reefstarnes/Solar_Glide_VTOL/Flightcontrol/README.md

# Flight control
Flight Controller:

Flasher4OTG:
