reefstarnes/Solar_Glide_VTOL/Flightcontrol/flashing_tool/dependencies/1N5819HW_7_F/1N5819HW-7-F.step

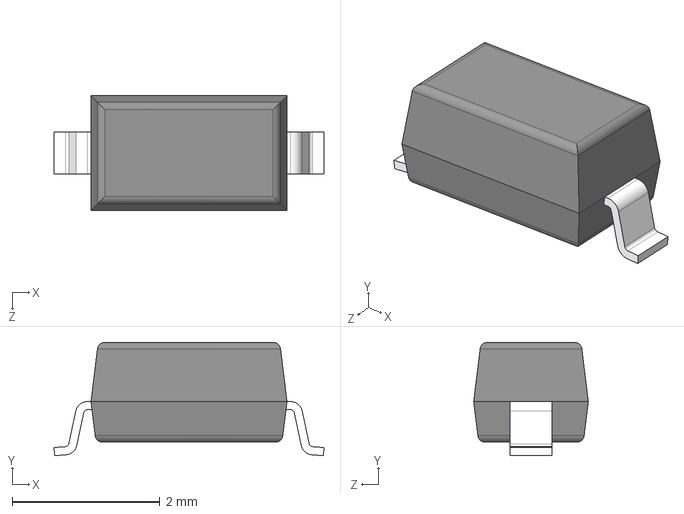
[picture p34: CAD file, 2025-10-27]
Flightcontrol/flashing_tool/dependencies/1N5819HW_7_F/1N5819HW-7-F.step
3.65 x 1.53 x 1.55 mm
