reefstarnes/Solar_Glide_VTOL/Flightcontrol/flashing_tool/dependencies/AMS1117-3.3/AMS1117-3.3.step

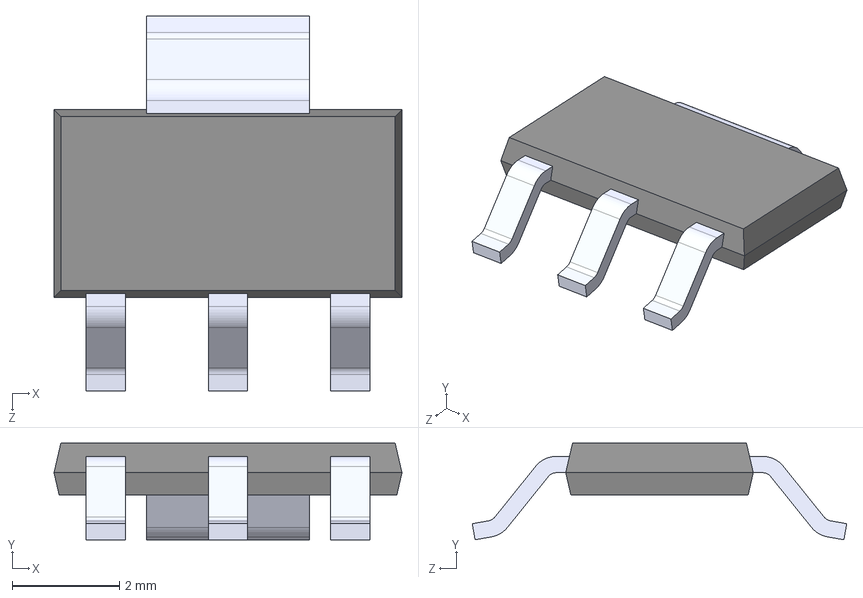
[picture p35: CAD file, 2025-11-11]
Flightcontrol/flashing_tool/dependencies/AMS1117-3.3/AMS1117-3.3.step
6.50 x 1.80 x 7.00 mm
