reefstarnes/Solar_Glide_VTOL/Flightcontrol/flashing_tool/dependencies/ESP32_S3_WROOM_1U_N16R8/ESP32-S3-WROOM-1U-N16R8.step

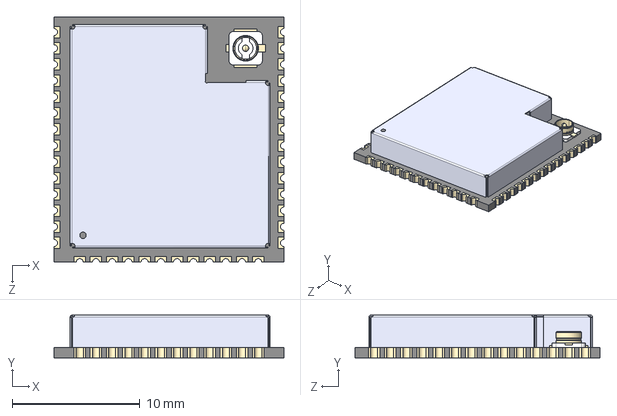
[picture p36: CAD file, 2025-10-26]
Flightcontrol/flashing_tool/dependencies/ESP32_S3_WROOM_1U_N16R8/ESP32-S3-WROOM-1U-N16R8.step
18.0 x 3.35 x 19.2 mm
