reefstarnes/Solar_Glide_VTOL/Flightcontrol/flashing_tool/dependencies/GSPTS0020/GSPTS0020.stp

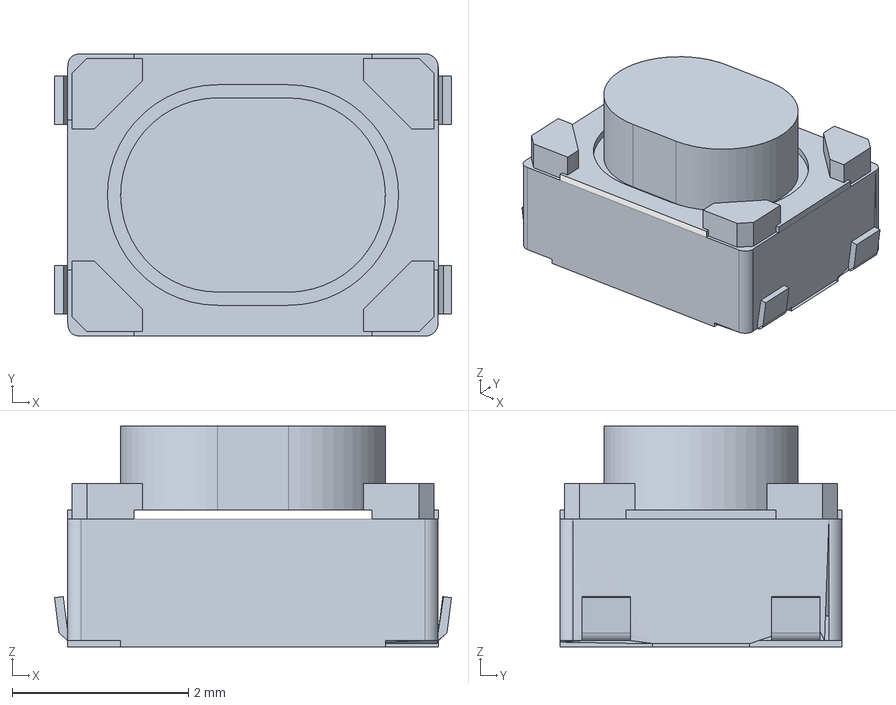
[picture p37: CAD file, 2025-11-11]
Flightcontrol/flashing_tool/dependencies/GSPTS0020/GSPTS0020.stp
4.50 x 3.20 x 2.50 mm
PTS815SJM250SMTRLFS_PART1
PTS815SJM250SMTRLFS_PART2
PTS815SJM250SMTRLFS_PART3
