reefstarnes/Solar_Glide_VTOL/Flightcontrol/flashing_tool/dependencies/TAJA226K010RNJ/TAJA226K010RNJ.step

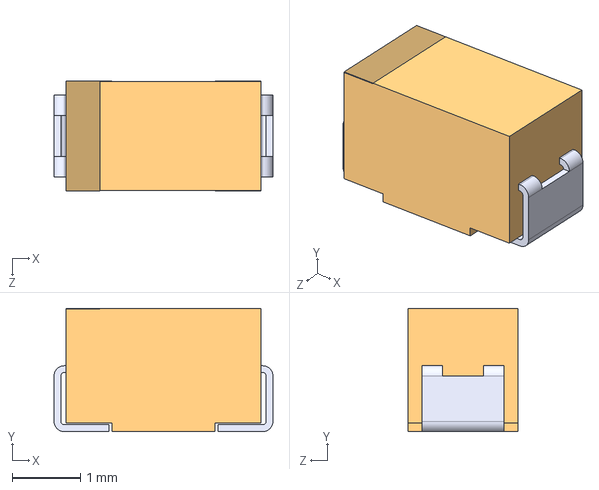
[picture p38: CAD file, 2025-11-11]
Flightcontrol/flashing_tool/dependencies/TAJA226K010RNJ/TAJA226K010RNJ.step
3.20 x 1.80 x 1.60 mm
