reefstarnes/Solar_Glide_VTOL/Flightcontrol/flashing_tool/dependencies/USBLC6_2SC6/USBLC6-2SC6.step

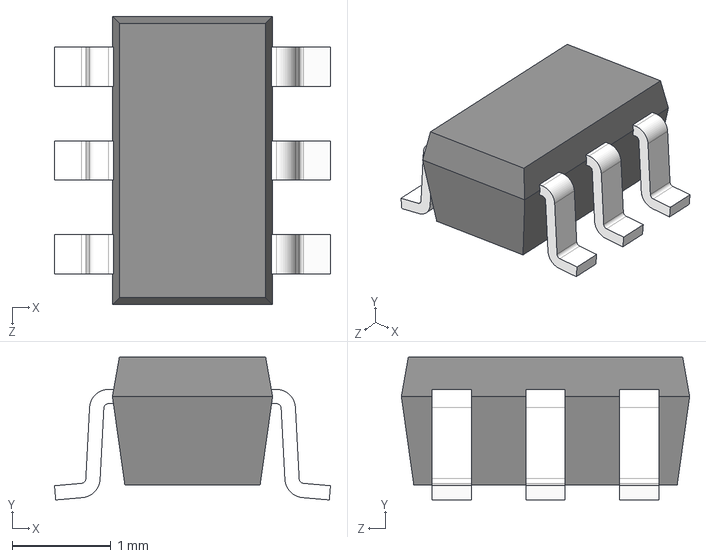
[picture p39: CAD file, 2025-10-27]
Flightcontrol/flashing_tool/dependencies/USBLC6_2SC6/USBLC6-2SC6.step
2.80 x 1.45 x 2.92 mm
