reefstarnes/Solar_Glide_VTOL/Flightcontrol/kicad/dependencies/BMP581/BMP581.stp

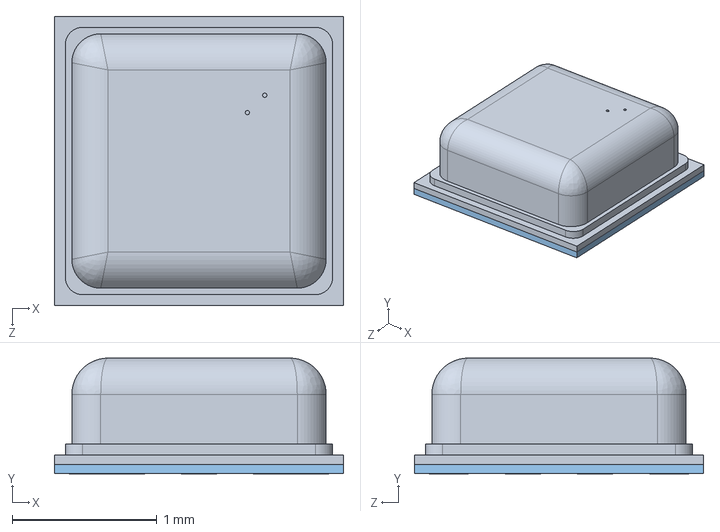
[picture p40: CAD file, 2025-11-11]
Flightcontrol/kicad/dependencies/BMP581/BMP581.stp
2.00 x 0.801 x 2.00 mm
