reefstarnes/Solar_Glide_VTOL/Flightcontrol/kicad/dependencies/CONN_CCSH-W10R-04TR-BK-A_ADA/SM04B-SRSS-TB.STEP

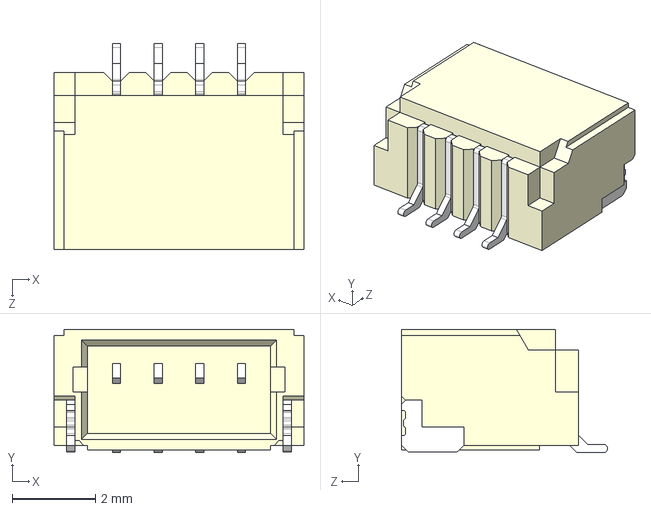
[picture p41: CAD file, 2025-11-11]
Flightcontrol/kicad/dependencies/CONN_CCSH-W10R-04TR-BK-A_ADA/SM04B-SRSS-TB.STEP
6.00 x 2.96 x 4.95 mm
