reefstarnes/Solar_Glide_VTOL/Flightcontrol/kicad/dependencies/CONN_SM03B-GHS-TBLFSN_JST/CONN_SM03B-GHS-TBLFSN_JST.STEP

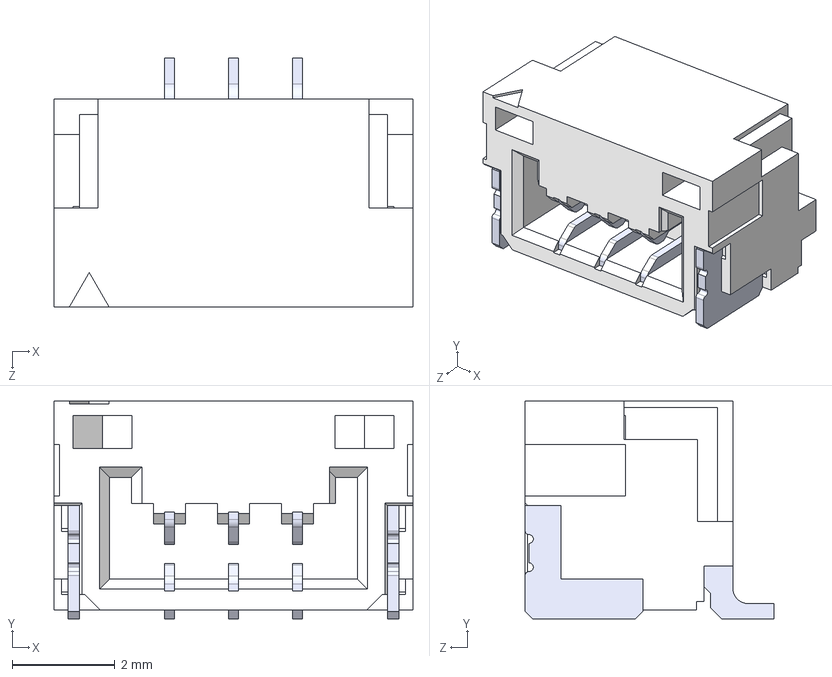
[picture p42: CAD file, 2025-11-11]
Flightcontrol/kicad/dependencies/CONN_SM03B-GHS-TBLFSN_JST/CONN_SM03B-GHS-TBLFSN_JST.STEP
7.00 x 4.25 x 4.85 mm
SMxB-GHS-TB_03
pin x 3
