reefstarnes/Solar_Glide_VTOL/Flightcontrol/kicad/dependencies/CONN_SM06B-GHS-TB_JST/CONN_SM06B-GHS-TB_JST.STEP

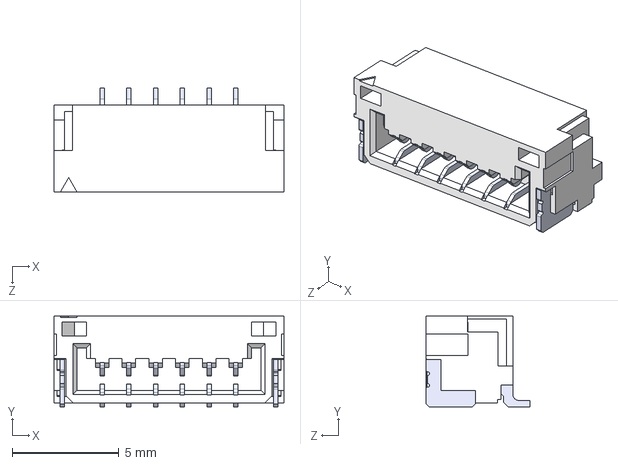
[picture p43: CAD file, 2025-11-11]
Flightcontrol/kicad/dependencies/CONN_SM06B-GHS-TB_JST/CONN_SM06B-GHS-TB_JST.STEP
10.8 x 4.25 x 4.85 mm
SMxB-GHS-TB_06
pin x 6
