reefstarnes/Solar_Glide_VTOL/Flightcontrol/kicad/dependencies/LESD5D5.0CT1G/LESD5D5.0CT1G.step

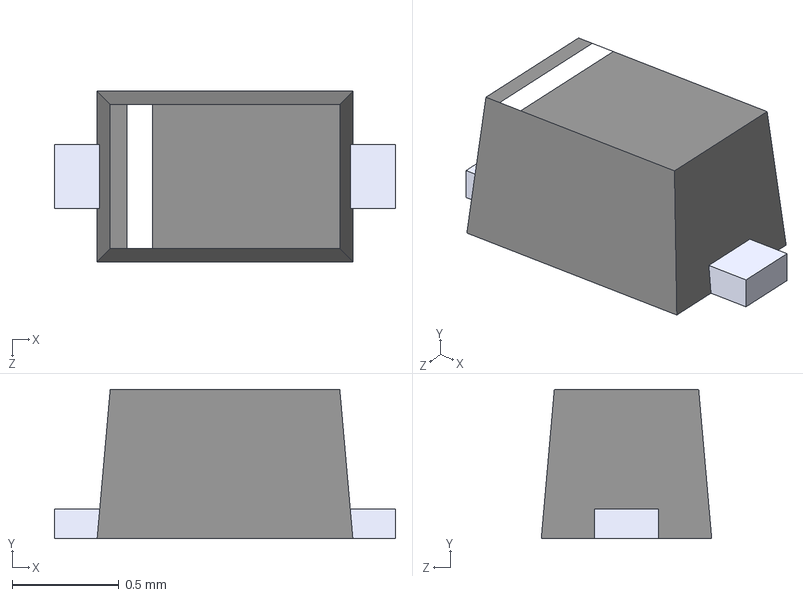
[picture p44: CAD file, 2025-10-30]
Flightcontrol/kicad/dependencies/LESD5D5.0CT1G/LESD5D5.0CT1G.step
1.60 x 0.7 x 0.8 mm
