reefstarnes/Solar_Glide_VTOL/Propcontrol/PropControl/Dependencies/C0603C103K5RACTU/C0603C103K5RACTU.step

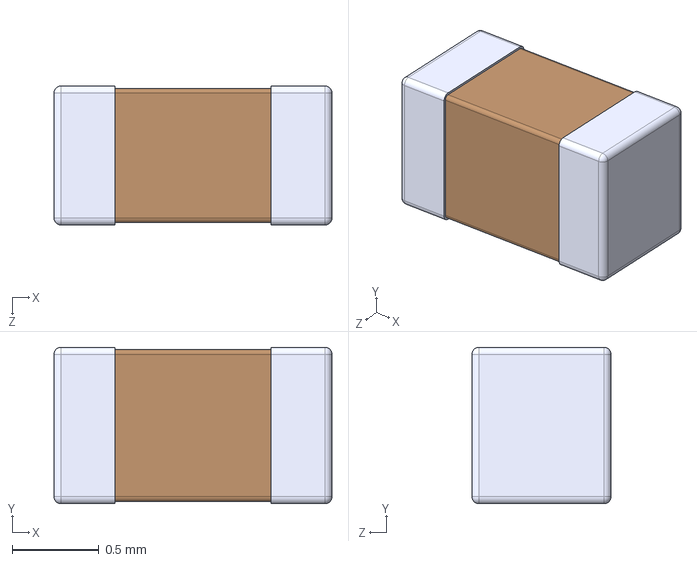
[picture p45: CAD file, 2025-11-11]
Propcontrol/PropControl/Dependencies/C0603C103K5RACTU/C0603C103K5RACTU.step
1.60 x 0.9 x 0.8 mm
