reefstarnes/Solar_Glide_VTOL/Propcontrol/PropControl/Dependencies/C0603C104K5RACTU/C0603C104K5RACTU.step

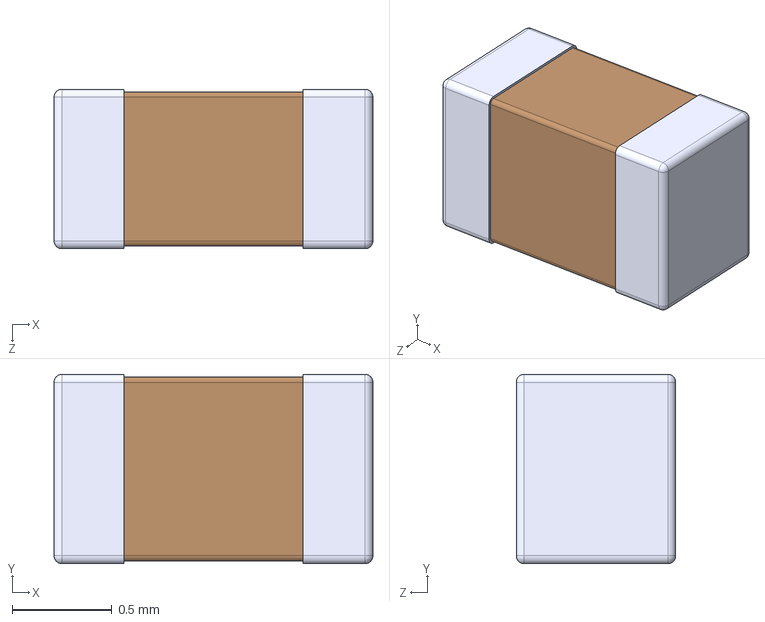
[picture p46: CAD file, 2025-11-11]
Propcontrol/PropControl/Dependencies/C0603C104K5RACTU/C0603C104K5RACTU.step
1.60 x 0.95 x 0.8 mm
