reefstarnes/Solar_Glide_VTOL/Propcontrol/PropControl/Dependencies/C3216X5R1E476M160AC/C3216X5R1E476M160AC.step

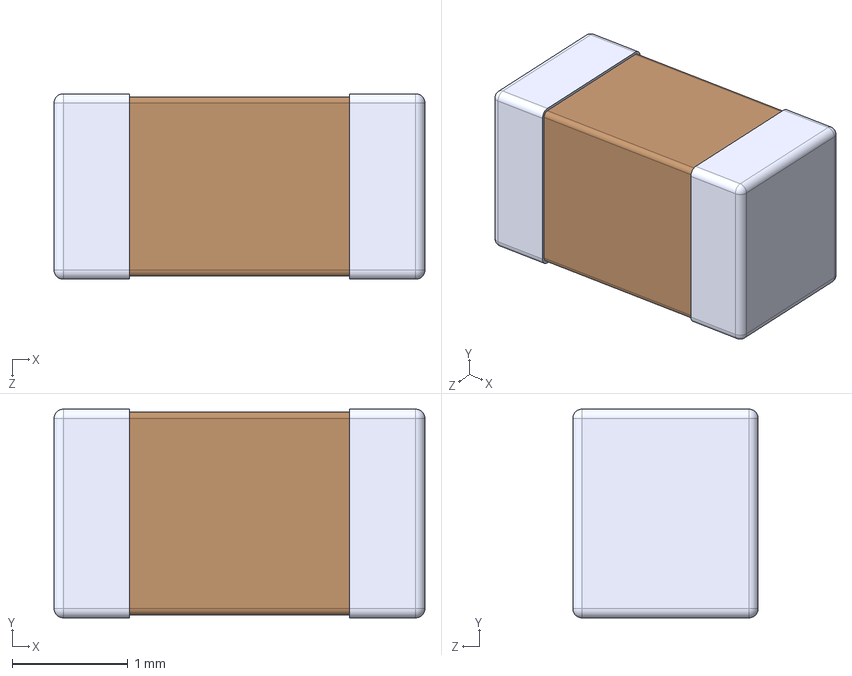
[picture p47: CAD file, 2025-11-11]
Propcontrol/PropControl/Dependencies/C3216X5R1E476M160AC/C3216X5R1E476M160AC.step
3.20 x 1.80 x 1.60 mm
