reefstarnes/Solar_Glide_VTOL/Propcontrol/PropControl/Dependencies/CL10B105KP8NNNC/CL10B105KP8NNNC.step

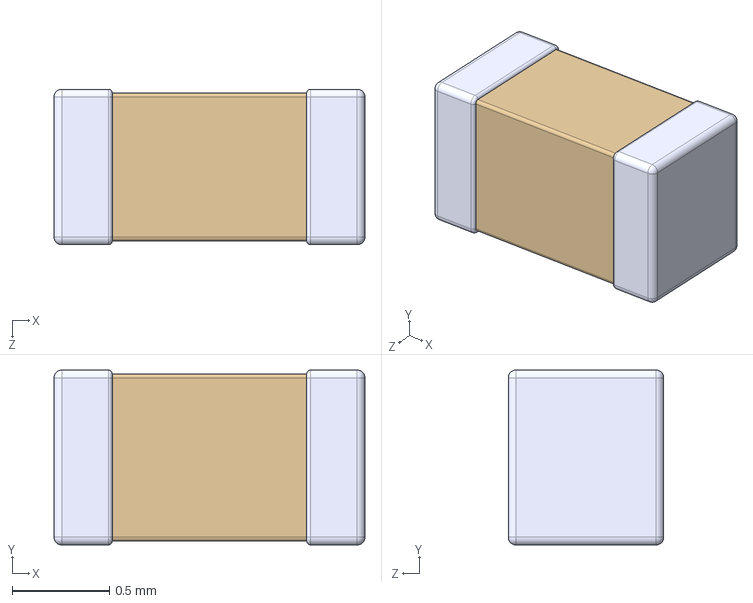
[picture p48: CAD file, 2026-01-29]
Propcontrol/PropControl/Dependencies/CL10B105KP8NNNC/CL10B105KP8NNNC.step
1.60 x 0.9 x 0.8 mm
