reefstarnes/Solar_Glide_VTOL/Propcontrol/PropControl/Dependencies/GRM188R61E106KA73D/GRM188R61E106KA73D.step

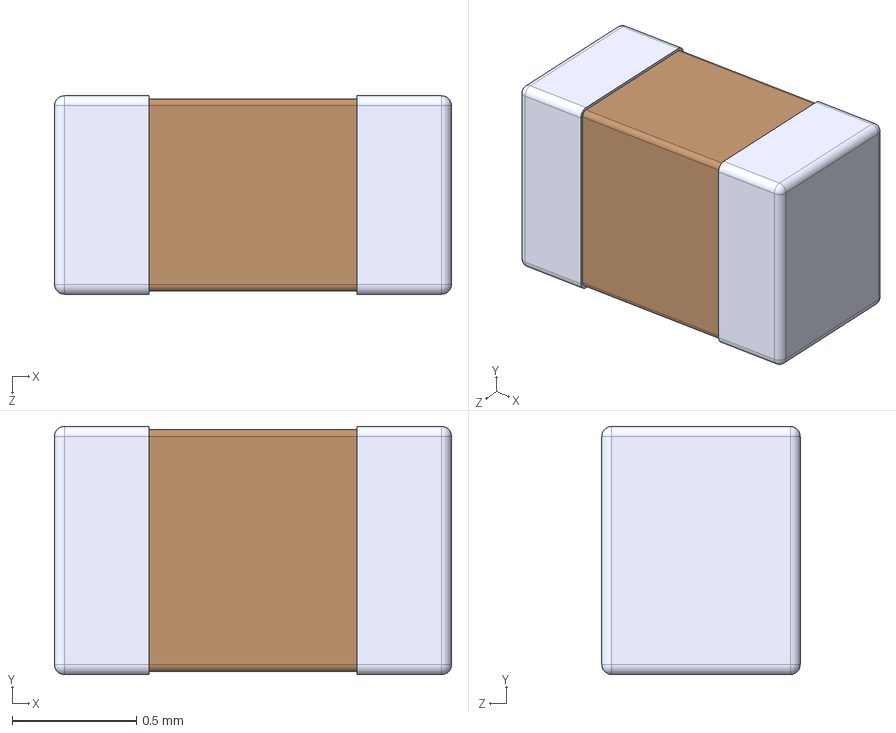
[picture p49: CAD file, 2025-11-11]
Propcontrol/PropControl/Dependencies/GRM188R61E106KA73D/GRM188R61E106KA73D.step
1.60 x 1.00 x 0.8 mm
