reefstarnes/Solar_Glide_VTOL/Propcontrol/PropControl/Dependencies/LM339D/LM339D.step

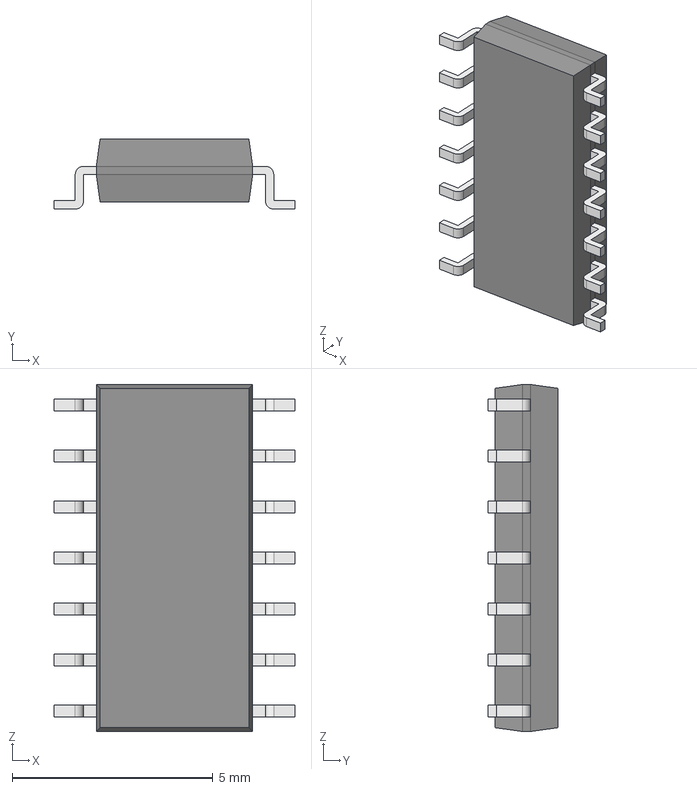
[picture p50: CAD file, 2025-11-11]
Propcontrol/PropControl/Dependencies/LM339D/LM339D.step
6.00 x 1.75 x 8.65 mm
Body001 (Mirror #1) x 7
XY-plane x 12
X-axis x 12
