reefstarnes/Solar_Glide_VTOL/Propcontrol/PropControl/Dependencies/STM32F030F4P6/STM32F030F4P6.step

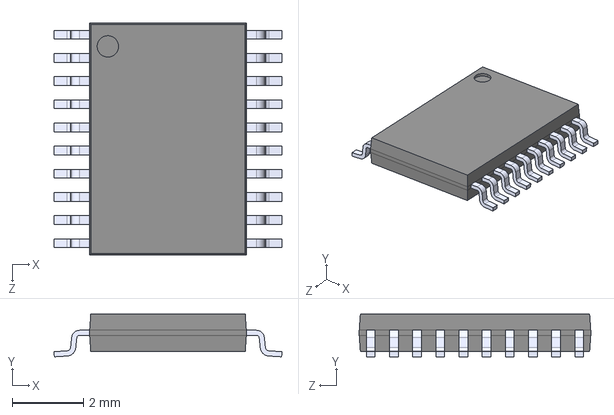
[picture p51: CAD file, 2025-11-11]
Propcontrol/PropControl/Dependencies/STM32F030F4P6/STM32F030F4P6.step
6.40 x 1.20 x 6.50 mm
