reefstarnes/Solar_Glide_VTOL/(list of files, cad)

Other CAD files:
Propcontrol/PropControl/Dependencies/UMK107AB7105KA_T (1)/UMK107AB7105KA-T.step
Flightcontrol/flashing_tool/dependencies/2171790001/2171790001.step
Propcontrol/PropControl/Dependencies/CSD18533Q5A/CSD18533Q5A.step
Propcontrol/PropControl/Dependencies/TPS62933DRLR/TPS62933DRLR.step
