reefstarnes/Solar_Glide_VTOL/(list of files, drawings)

Other design files:
Flightcontrol/testcode/COMM_SIMULATION_CIRCUIT.fzz
