reefstarnes/Solar_Glide_VTOL/Flightcontrol/flashing_tool/kicad.kicad_pcb

## KiCad design Flightcontrol/flashing_tool/kicad.kicad_pcb (2025-11-11)

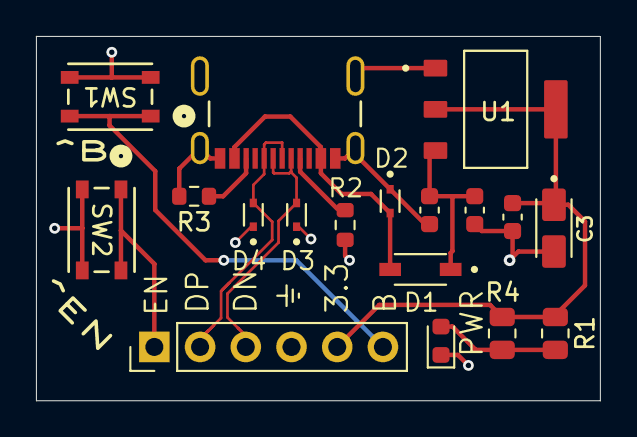
[picture p52: board Flightcontrol/flashing_tool/kicad.kicad_pcb from above]

Board: 2 copper layers, 31.3 x 20.2 mm, 18 parts (0 on the bottom side), 11 nets.

Parts:
C1, C4: 0.1uF; C_0603_1608Metric
C2: 10uF; C_0603_1608Metric
C3: 22uF; CAPMP3216X180N
D1: 1N5819HW-7-F; SOD3715X145N
D2, D3, D4: LESD5D5.0CT1G; TVS_LESD5D5.0CT1G
J1: 2171790001; MOLEX_2171790001
J2: Conn_01x06_Pin; PinHeader_1x06_P2.54mm_Vertical
PWR: LED; LED_0603_1608Metric
R1, R4: 560; R_0805_2012Metric
R2, R3: 5.1k; R_0603_1608Metric
SW1, SW2: PTS815 SJM 250 SMTR LFS; GSPTS0020
U1: AMS1117-3.3; SOT229P700X180-4N

Connections:
/3.3: C3.1, C4.1, J2.5, R1.1, R4.1, U1.2 (VOUT)
/D+: D4.2, J1.A6 (DP1), J1.B6 (DP2), J2.2
/D-: D3.2, J1.A7 (DN1), J1.B7 (DN2), J2.3
/S1: J2.1, SW2.1, SW2.2
/S2: J2.6, SW1.1, SW1.2
/VCC_5V: C1.1, C2.1, D1.C, U1.3 (VIN)
GND: C1.2, C2.2, C3.2, C4.2, D2.1, D3.1, D4.1, J1.A1B12 (GND1), J1.B1A12 (GND2), J1.SH1 (SHIELD1), J1.SH2 (SHIELD2), J1.SH3 (SHIELD3), J1.SH4 (SHIELD4), J2.4, PWR.1 (K), R2.2, R3.2, SW1.3, SW1.4, SW2.3, SW2.4, U1.1 (GND/ADJ)
unnamed: PWR.2 (A), R1.2, R4.2
unnamed: J1.A5 (CC1), R2.1
unnamed: J1.B5 (CC2), R3.1
unnamed: D1.A, D2.2, J1.A4B9 (VBUS1), J1.B4A9 (VBUS2)
