reefstarnes/Solar_Glide_VTOL/Flightcontrol/kicad/kicad.kicad_pcb

## KiCad design Flightcontrol/kicad/kicad.kicad_pcb (2025-11-11)

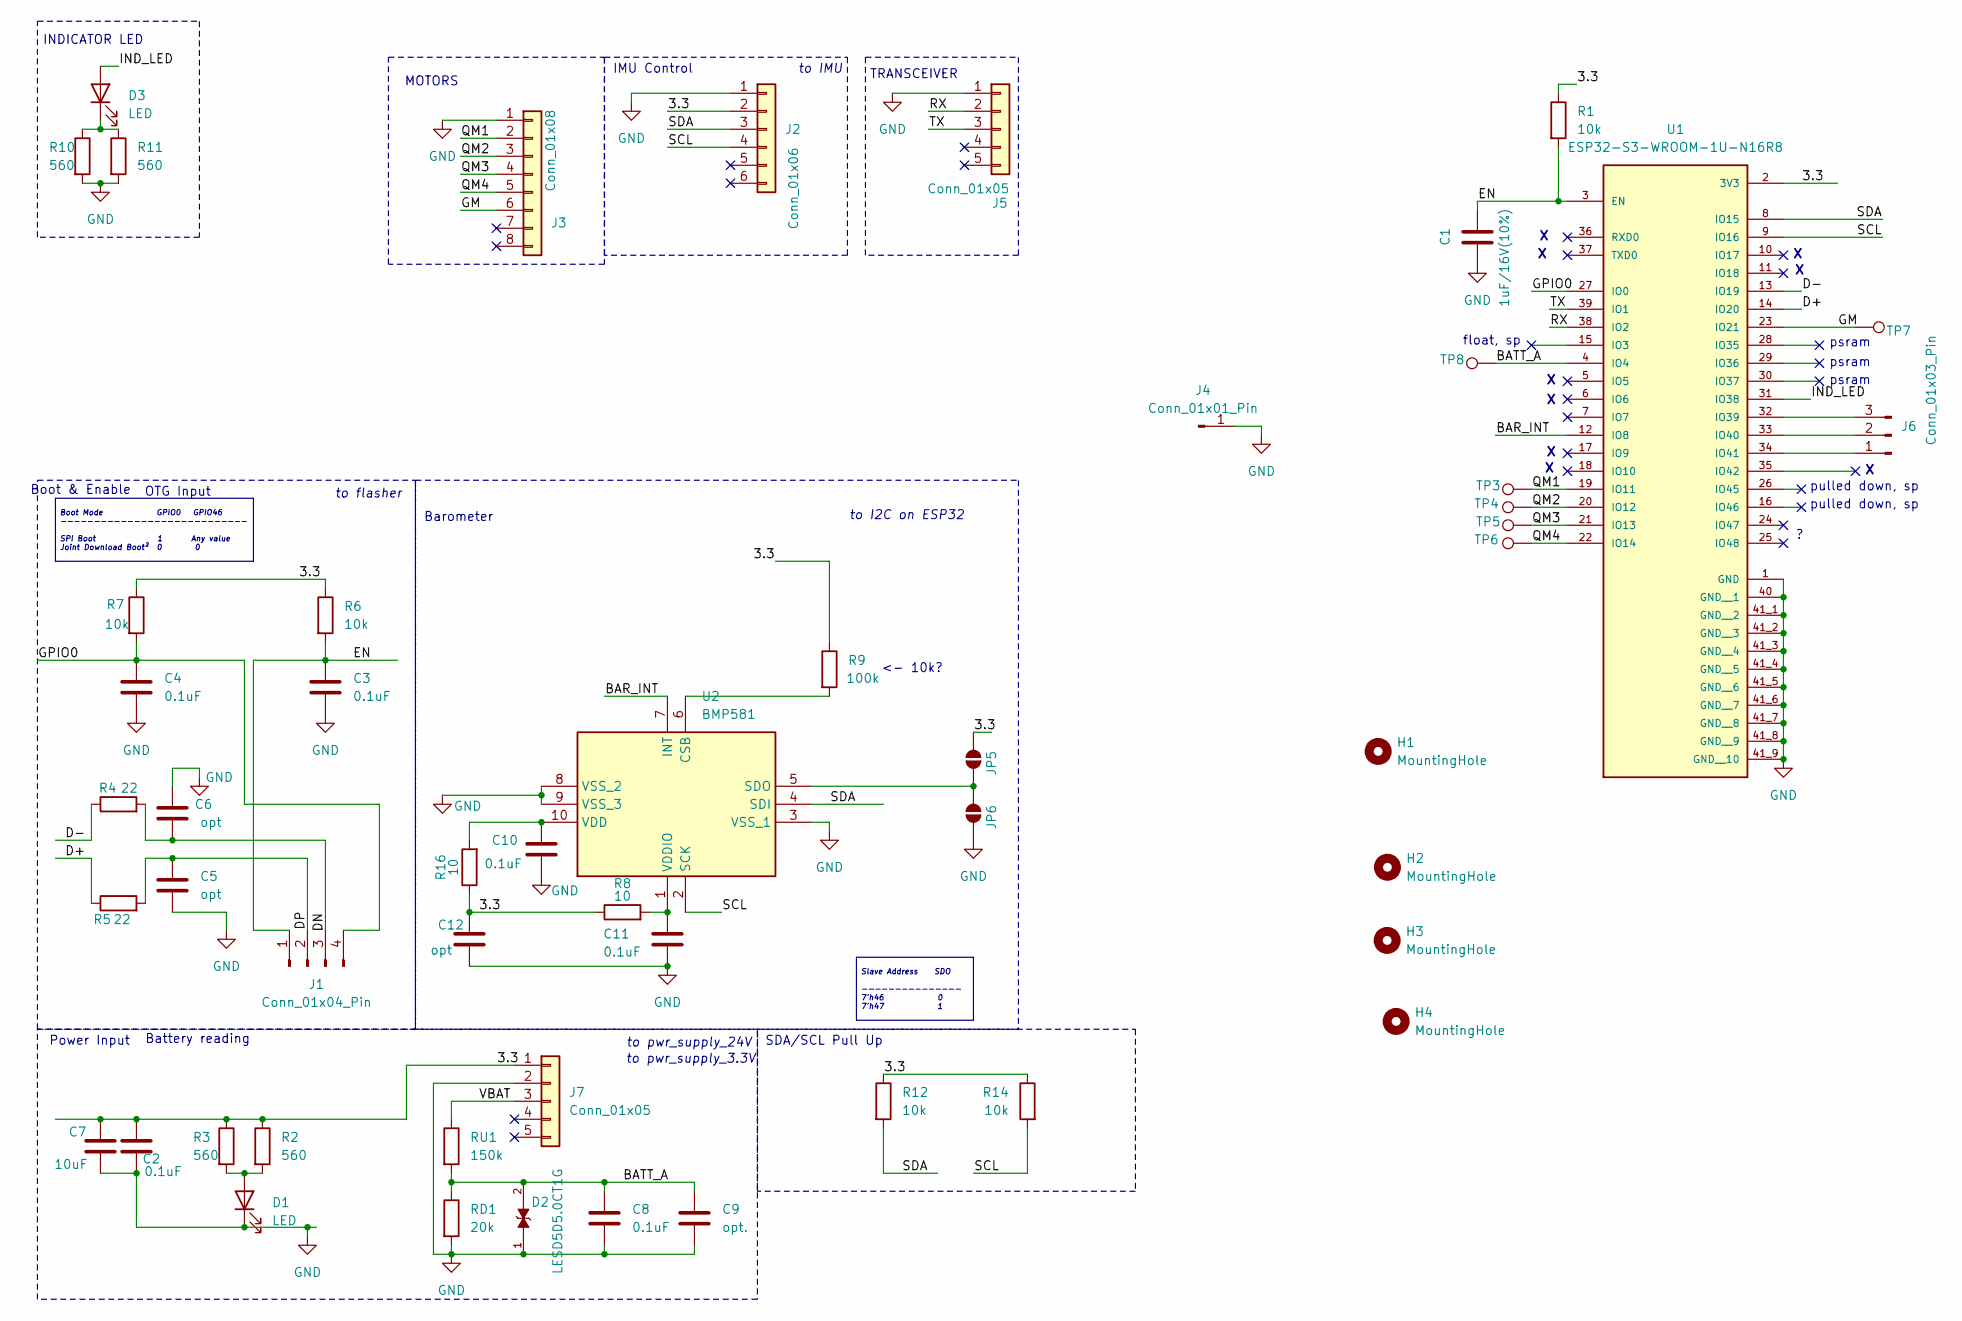
[picture p53: schematic kicad.kicad_sch]

Parts:
C1: 1uF/16V(10%); C_0603_1608Metric
C2, C3, C4, C8, C10, C11: 0.1uF; C_0603_1608Metric
C5, C6, C12: opt; C_0603_1608Metric
C7: 10uF; C_0603_1608Metric
C9: opt.; C_0603_1608Metric
D1, D3: LED; LED_0603_1608Metric
D2: LESD5D5.0CT1G; TVS_LESD5D5.0CT1G; PARTREV O
H1, H2, H3, H4: MountingHole; MountingHole_2.2mm_M2
J1: Conn_01x04_Pin; PinHeader_1x04_P2.54mm_Vertical
J2: Conn_01x06; CONN_CCSH-W10R-04TR-BK-A_ADA
J3: Conn_01x08; CONN_SM06B-GHS-TB_JST
J4: Conn_01x01_Pin; PinHeader_1x01_P2.54mm_Vertical
J5, J7: Conn_01x05; CONN_SM03B-GHS-TBLFSN_JST
J6: Conn_01x03_Pin; PinHeader_1x03_P2.54mm_Vertical
JP5, JP6: SolderJumper_2_Open; SolderJumper-2_P1.3mm_Open_RoundedPad1.0x1.5mm
R1, R6, R7, R12, R14: 10k; R_0603_1608Metric
R2, R3, R10, R11: 560; R_0805_2012Metric
R4, R5: 22; R_0603_1608Metric
R8, R16: 10; R_0603_1608Metric
R9: 100k; R_0603_1608Metric
RD1: 20k; R_0805_2012Metric
RU1: 150k; R_0603_1608Metric
TP3, TP5, TP7, TP8: x; TestPoint_Pad_D1.5mm
TP4, TP6: BAR_CLK; TestPoint_Pad_D1.5mm
U1: ESP32-S3-WROOM-1U-N16R8; ESP32-S3-WROOM-1U; PARTREV v1.1
U2: BMP581; Mouser Part Number 262-BMP581

Connections:
/3.3: C2.1, C7.1, C12.1, J2.2, J7.1, JP5.2 (B), R1.1, R2.1, R3.1, R6.1, R7.1, R8.1, R9.1, R12.1, R14.1, R16.1, U1.2 (3V3)
/BAR_INT: U1.12 (IO8), U2.7 (INT)
/BATT_A: C8.1, C9.1, D2.2, RD1.1, RU1.2, TP8.1, U1.4 (IO4)
/D+: R5.1, U1.14 (IO20)
/D-: R4.1, U1.13 (IO19)
/DN: C6.2, J1.3, R4.2
/DP: C5.1, J1.2, R5.2
/EN: C1.1, C3.1, J1.1, R1.2, R6.2, U1.3 (EN)
/GM: J3.6, TP7.1, U1.23 (IO21)
/GPIO0: C4.1, J1.4, R7.2, U1.27 (IO0)
/IND_LED: D3.2 (A), U1.31 (IO38)
/QM1: J3.2, TP3.1, U1.19 (IO11)
/QM2: J3.3, TP4.1, U1.20 (IO12)
/QM3: J3.4, TP5.1, U1.21 (IO13)
/QM4: J3.5, TP6.1, U1.22 (IO14)
/RX: J5.2, U1.38 (IO2)
/SCL: J2.4, R14.2, U1.9 (IO16), U2.2 (SCK)
/SDA: J2.3, R12.2, U1.8 (IO15), U2.4 (SDI)
/TX: J5.3, U1.39 (IO1)
/VBAT: J7.3, RU1.1
GND: C1.2, C2.2, C3.2, C4.2, C5.2, C6.1, C7.2, C8.2, C9.2, C10.2, C11.2, C12.2, D1.1 (K), D2.1, J2.1, J3.1, J4.1, J5.1, J7.2, JP6.1 (A), R10.2, R11.2, RD1.2, U1.1 (GND), U1.40 (GND__1), U1.41, U1.41_1 (GND__2), U1.41_2 (GND__3), U1.41_3 (GND__4), U1.41_4 (GND__5), U1.41_5 (GND__6), U1.41_6 (GND__7), U1.41_7 (GND__8), U1.41_8 (GND__9), U1.41_9 (GND__10), U2.3 (VSS_1), U2.8 (VSS_2), U2.9 (VSS_3)
unnamed: D1.2 (A), R2.2, R3.2
unnamed: D3.1 (K), R10.1, R11.1
unnamed: J6.1, U1.34 (IO41)
unnamed: J6.2, U1.33 (IO40)
unnamed: J6.3, U1.32 (IO39)
unnamed: JP5.1 (A), JP6.2 (B), U2.5 (SDO)
unnamed: R9.2, U2.6 (CSB)
unnamed: C10.1, R16.2, U2.10 (VDD)
unnamed: C11.1, R8.2, U2.1 (VDDIO)

Notes on the sheet:
to pwr_supply_24V
OTG Input
to IMU
MOTORS
Barometer
float, sp
Battery reading
Power Input
to I2C on ESP32
psram
to pwr_supply_3.3V
Boot & Enable
<- 10k?
pulled down, sp
TRANSCEIVER
IMU Control
INDICATOR LED
to flasher
SDA/SCL Pull Up
Slave Address SDO --------------- 7'h46 0 7'h47 1
Boot Mode GPIO0 GPIO46 ---------------------------- SPI Boot 1 Any value Joint Download Boot² 0 0

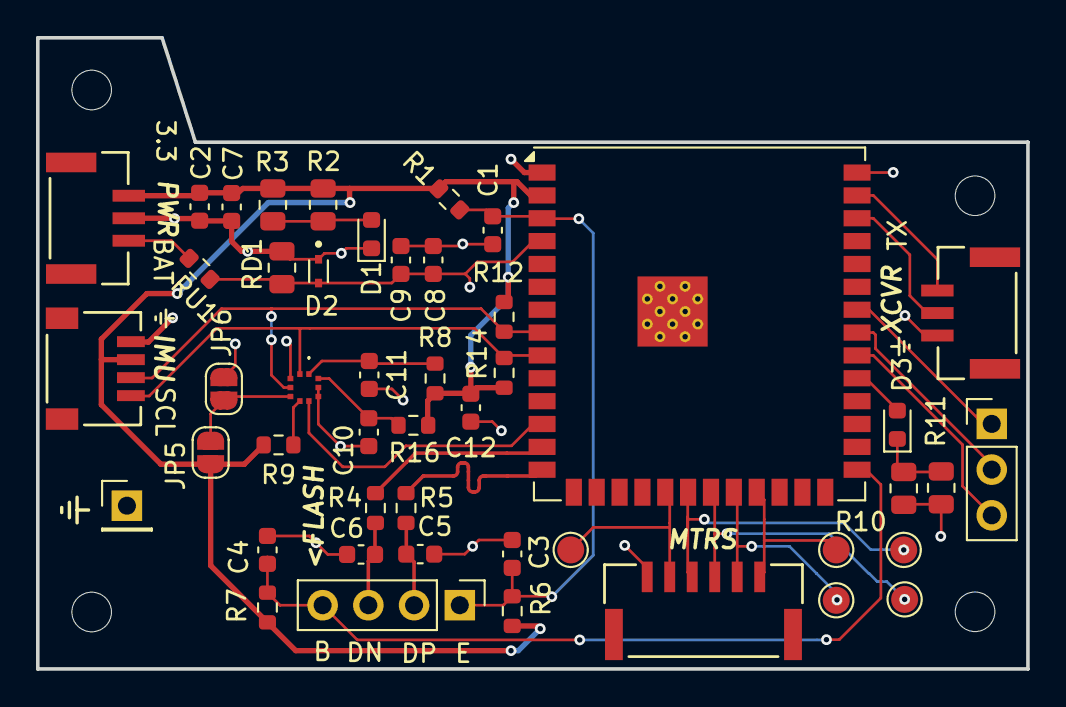
[picture p54: board Flightcontrol/kicad/kicad.kicad_pcb from above]

Board: 2 copper layers, 55.0 x 35.1 mm, 52 parts (1 on the bottom side), 30 nets.
