reefstarnes/Solar_Glide_VTOL/Propcontrol/PropControl/PropControl.kicad_pcb

## KiCad design Propcontrol/PropControl/PropControl.kicad_pcb (2025-11-11)

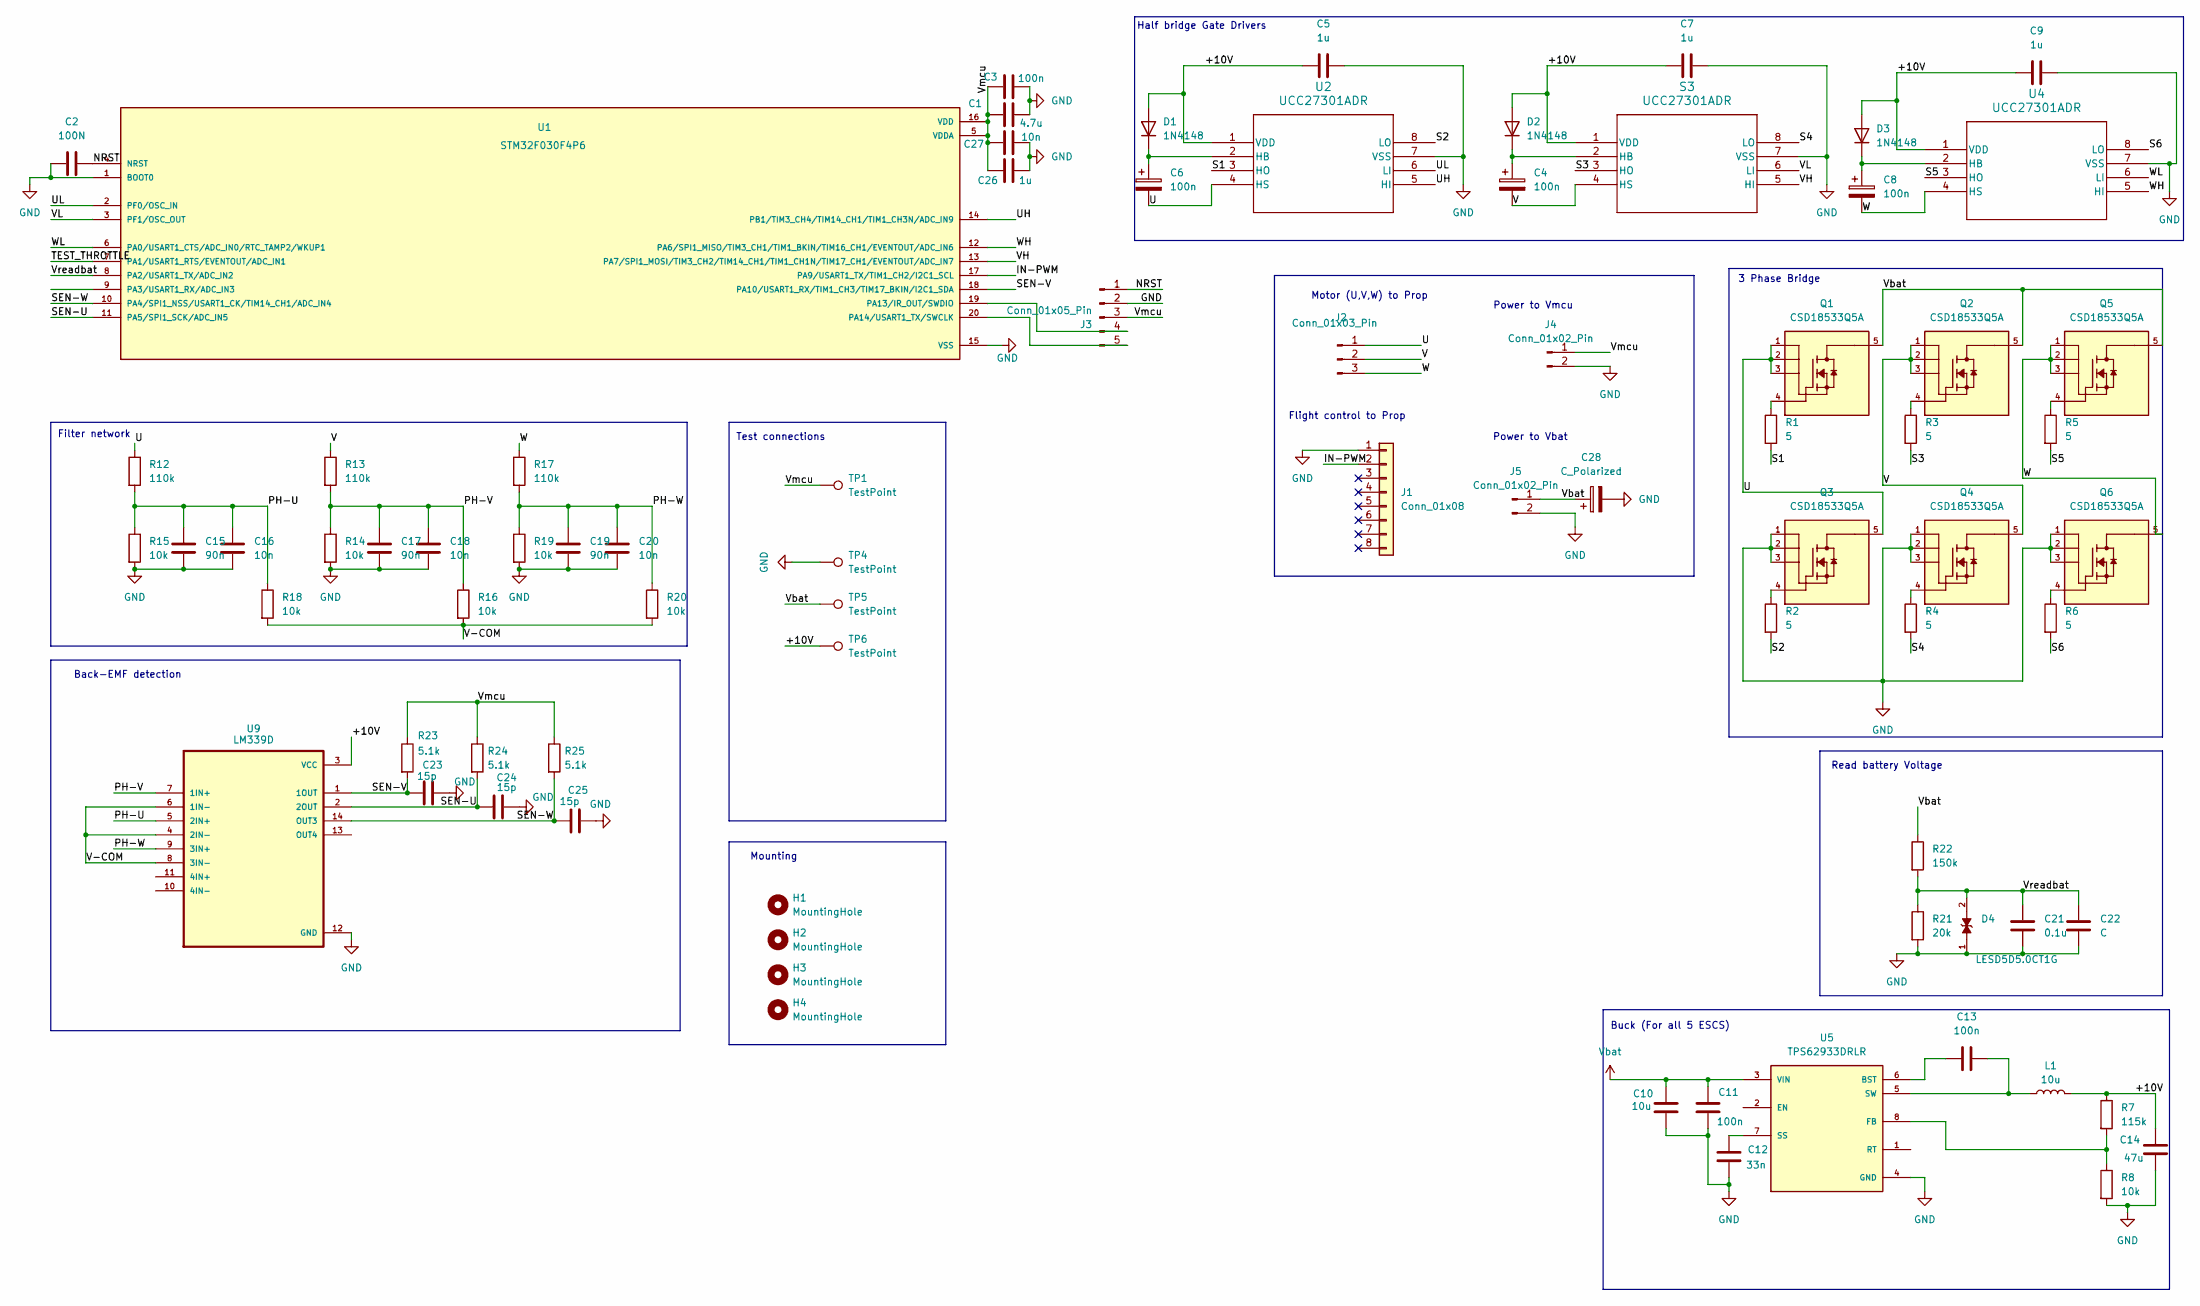
[picture p55: schematic PropControl.kicad_sch]

Parts:
C1: 4.7u; C_0603_1608Metric
C2: 100N; C_0603_1608Metric
C3: 100n; CAPC1608X90 100nF
C4, C6, C8, C11, C13: 100n; C_0603_1608Metric
C5, C7, C9, C27: 1u; C_0603_1608Metric
C10: 10u; C_0603_1608Metric
C12: 33n; C_1206_3216Metric
C14: 47u; C_1206_3216Metric
C15, C17, C19: 90n; CAPC1608X90 100nF
C16, C18, C20, C26: 10n; CAPC1608X90N 10nF
C21: 0.1u; C_0603_1608Metric
C22: C; C_0603_1608Metric
C23, C24, C25: 15p; C_0603_1608Metric
C28: C_Polarized; CP_Radial_D12.5mm_P5.00mm
D1, D2, D3: 1N4148; D_DO-35_SOD27_P7.62mm_Horizontal
D4: LESD5D5.0CT1G; TVS_LESD5D5.0CT1G; PARTREV O
H1, H2, H3, H4: MountingHole; MountingHole_2.2mm_M2
J1: Conn_01x08; CONN_SM06B-GHS-TB_JST
J2: Conn_01x03_Pin; MR60PW-M
J3: Conn_01x05_Pin; PinHeader_1x05_P2.54mm_Vertical
J4: Conn_01x02_Pin; JST_PH_B2B-PH-K_1x02_P2.00mm_Vertical
J5: Conn_01x02_Pin; AMASS_XT60-M_1x02_P7.20mm_Vertical
L1: 10u; L_0805_2012Metric
Q1, Q2, Q3, Q4, Q5, Q6: CSD18533Q5A; VSON-8_3.3x3.3mm_P0.65mm_NexFET; PARTREV B
R1, R2, R3, R4, R5, R6: 5; R_0603_1608Metric
R7: 115k; R_0805_2012Metric
R8, R14, R15, R16, R18, R19, R20: 10k; R_0603_1608Metric
R12, R13, R17: 110k; R_1206_3216Metric
R21: 20k; R_0603_1608Metric
R22: 150k; R_0603_1608Metric
R23, R24, R25: 5.1k; R_0603_1608Metric
S3: UCC27301ADR; SOIC8_D_TEX
TP1, TP4, TP5, TP6: TestPoint; TestPoint_Pad_D1.5mm
U1: STM32F030F4P6; SOP65P640X120-20N
U2, U4: UCC27301ADR; SOIC8_D_TEX
U5: TPS62933DRLR; SOTFL50P160X60-8N; PARTREV D
U9: LM339D; SOIC127P600X175-14N

Connections:
/+10V: C5.1, C7.1, C9.1, C14.1, D1.2 (A), D2.2 (A), D3.2 (A), L1.2, R7.1, S3.1 (VDD), TP6.1, U2.1 (VDD), U4.1 (VDD), U9.3 (VCC)
/IN-PWM: J1.2, U1.17 (PA9/USART1_TX/TIM1_CH2/I2C1_SCL)
/NRST: C2.2, J3.1, U1.4 (NRST)
/PH-U: C15.1, C16.1, R12.2, R15.1, R18.1, U9.5 (2IN+)
/PH-V: C17.1, C18.1, R13.2, R14.1, R16.1, U9.7 (1IN+)
/PH-W: C19.1, C20.1, R17.2, R19.1, R20.1, U9.9 (3IN+)
/S1: R1.2, U2.3 (HO)
/S2: R2.2, U2.8 (LO)
/S3: R3.2, S3.3 (HO)
/S4: R4.2, S3.8 (LO)
/S5: R5.2, U4.3 (HO)
/S6: R6.2, U4.8 (LO)
/SEN-U: C24.1, R24.2, U1.11 (PA5/SPI1_SCK/ADC_IN5), U9.2 (2OUT)
/SEN-V: C23.1, R23.2, U1.18 (PA10/USART1_RX/TIM1_CH3/TIM17_BKIN/I2C1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), U9.1 (1OUT)
/SEN-W: C25.1, R25.2, U1.10 (PA4/SPI1_NSS/USART1_CK/TIM14_CH1/ADC_IN4), U9.14 (OUT3)
/TEST_THROTTLE: U1.7 (PA1/USART1_RTS/EVENTOUT/ADC_IN1)
/U: C6.2, J2.1, Q1.1, Q1.2, Q1.3, Q3.5, R12.1, U2.4 (HS)
/UH: U1.14 (PB1/TIM3_CH4/TIM14_CH1/TIM1_CH3N/ADC_IN9), U2.5 (HI)
/UL: U1.2 (PF0/OSC_IN), U2.6 (LI)
/V: C4.2, J2.2, Q2.1, Q2.2, Q2.3, Q4.5, R13.1, S3.4 (HS)
/V-COM: R16.2, R18.2, R20.2, U9.4 (2IN-), U9.6 (1IN-), U9.8 (3IN-)
/VH: S3.5 (HI), U1.13 (PA7/SPI1_MOSI/TIM3_CH2/TIM14_CH1/TIM1_C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)
/VL: S3.6 (LI), U1.3 (PF1/OSC_OUT)
/Vmcu: C1.1, C3.1, C26.1, C27.1, J3.3, J4.1, R23.1, R24.1, R25.1, TP1.1, U1.5 (VDDA), U1.16 (VDD)
/Vreadbat: C21.1, C22.1, D4.2, R21.1, R22.2, U1.8 (PA2/USART1_TX/ADC_IN2)
/W: C8.2, J2.3, Q5.1, Q5.2, Q5.3, Q6.5, R17.1, U4.4 (HS)
/WH: U1.12 (PA6/SPI1_MISO/TIM3_CH1/TIM1_BKIN/TIM16_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), U4.5 (HI)
/WL: U1.6 (PA0/USART1_CTS/ADC_IN0/RTC_TAMP2/WKUP1), U4.6 (LI)
GND: C1.2, C2.1, C3.2, C5.2, C7.2, C9.2, C10.2, C11.2, C12.2, C14.2, C15.2, C16.2, C17.2, C18.2, C19.2, C20.2, C21.2, C22.2, C23.2, C24.2, C25.2, C26.2, C27.2, C28.2, D4.1, J1.1, J3.2, J4.2, J5.2, Q3.1, Q3.2, Q3.3, Q4.1, Q4.2, Q4.3, Q6.1, Q6.2, Q6.3, R8.2, R14.2, R15.2, R19.2, R21.2, S3.7 (VSS), TP4.1, U1.1 (BOOT0), U1.15 (VSS), U2.7 (VSS), U4.7 (VSS), U5.4 (GND), U9.12 (GND)
unnamed: C6.1, D1.1 (K), U2.2 (HB)
unnamed: C4.1, D2.1 (K), S3.2 (HB)
unnamed: C8.1, D3.1 (K), U4.2 (HB)
unnamed: J3.4, U1.19 (PA13/IR_OUT/SWDIO)
unnamed: J3.5, U1.20 (PA14/USART1_TX/SWCLK)
unnamed: Q1.4, R1.1
unnamed: Q2.4, R3.1
unnamed: Q3.4, R2.1
unnamed: Q4.4, R4.1
unnamed: Q5.4, R5.1
unnamed: Q6.4, R6.1
unnamed: C13.1, U5.6 (BST)
unnamed: R7.2, R8.1, U5.8 (FB)
unnamed: C12.1, U5.7 (SS)
unnamed: C13.2, L1.1, U5.5 (SW)
Vbat: C10.1, C11.1, C28.1, J5.1, Q1.5, Q2.5, Q5.5, R22.1, TP5.1, U5.3 (VIN)

Notes on the sheet:
Flight control to Prop
Power to Vmcu
Mounting
Power to Vbat
Test connections
Half bridge Gate Drivers
Buck (For all 5 ESCS)
3 Phase Bridge
Back-EMF detection
Motor (U,V,W) to Prop
Read battery Voltage
Filter network

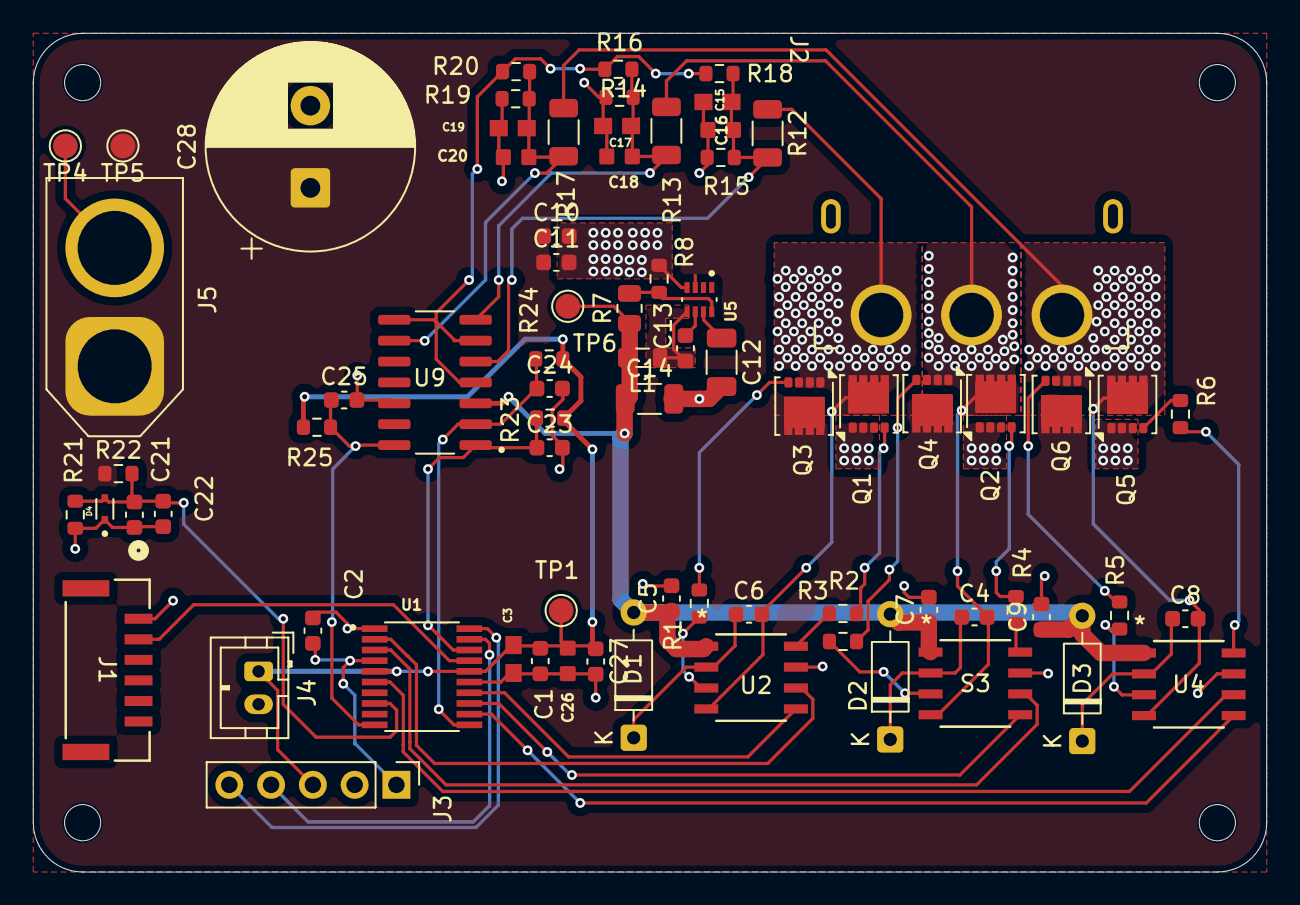
[picture p56: board PropControl.kicad_pcb from above]

Board: 2 copper layers, 75.0 x 51.0 mm, 80 parts (0 on the bottom side), 44 nets.
