reefstarnes/Solar_Glide_VTOL/(commit log)

2025-10-26 begun schematic :)
    [ESP32-S3-WROOM-1U-N16R8.step, kicad.kicad_pcb, kicad.kicad_sch]
2025-10-27 begun usbc programmer
    [1N5819HW-7-F.step, 2171790001.step, USBLC6-2SC6.step, kicad.kicad_sch]
2025-10-30 moved flash tool to seperate kicad file
    [1N5819HW-7-F.step, 2171790001.step, ESP32-S3-WROOM-1U-N16R8.step, LESD5D5.0CT1G.step, USBLC6-2SC6.step, kicad.kicad_pcb, kicad.kicad_sch]
2025-11-05 flasher4otg V1 finished
    [AMS1117-3.3.step, BMP581.stp, GSPTS0020.stp, LESD5D5.0CT1G.step, SM04B-SRSS-TB.STEP, TAJA226K010RNJ.step, kicad.kicad_sch]
2025-11-06 finished main schematic
    [CONN_SM03B-GHS-TBLFSN_JST.STEP, CONN_SM06B-GHS-TB_JST.STEP, kicad.kicad_sch]
2025-11-08 backing up for personal reasons
    [kicad.kicad_pcb, kicad.kicad_sch]
2025-11-10 sanity backup
    [kicad.kicad_pcb, kicad.kicad_sch]
2025-11-10 FC.V1 PCB Layout completed
    [kicad.kicad_pcb, kicad.kicad_sch]
2025-11-10 generated pcb files :)
    [BOM-kicad.csv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]
2025-11-11 V1 PC Schematic and PCB Finished
    [C0603C103K5RACTU.step, C0603C104K5RACTU.step, C3216X5R1E476M160AC.step, CONN_SM06B-GHS-TB_JST.STEP, CSD18533Q5A.step, GRM188R61E106KA73D.step, LESD5D5.0CT1G.step, LM339D.step]
2026-01-29 changes january 29th
    [C0603C103K5RACTU.step, CL10B105KP8NNNC.step, PropControl.kicad_sch, PropControlPCB_bom.csv]
2026-05-02 added esc testcode for debug
2026-05-02 added simulation circuit diagram for comm
    [COMM_SIMULATION_CIRCUIT.fzz]
2026-05-05 implimented motor control via comm
2026-05-06 calibrated IMU & added gyro logging
2026-05-06 false readings of IMU now return old valid readings
2026-05-06 implimented kill switch
2026-05-06 throttles up to 0.5
2026-05-06 mapped steer channel data to -1 to 1
2026-05-06 added filtering for gyro data
2026-05-06 more bug fixes to PID
    [Flightcontrol.cpp]
2026-05-06 even more bug fixes to PID
    [Flightcontrol.cpp]
