reefstarnes/Solar_Glide_VTOL/(notices)

Notices in the files:
Flightcontrol/flashing_tool/dependencies/GSPTS0020/GSPTS0020.stp:
author */ ('License CC BY-ND 4.0'),
